mbuesch/moistcontrol/schematics/moistcontrol.pdf

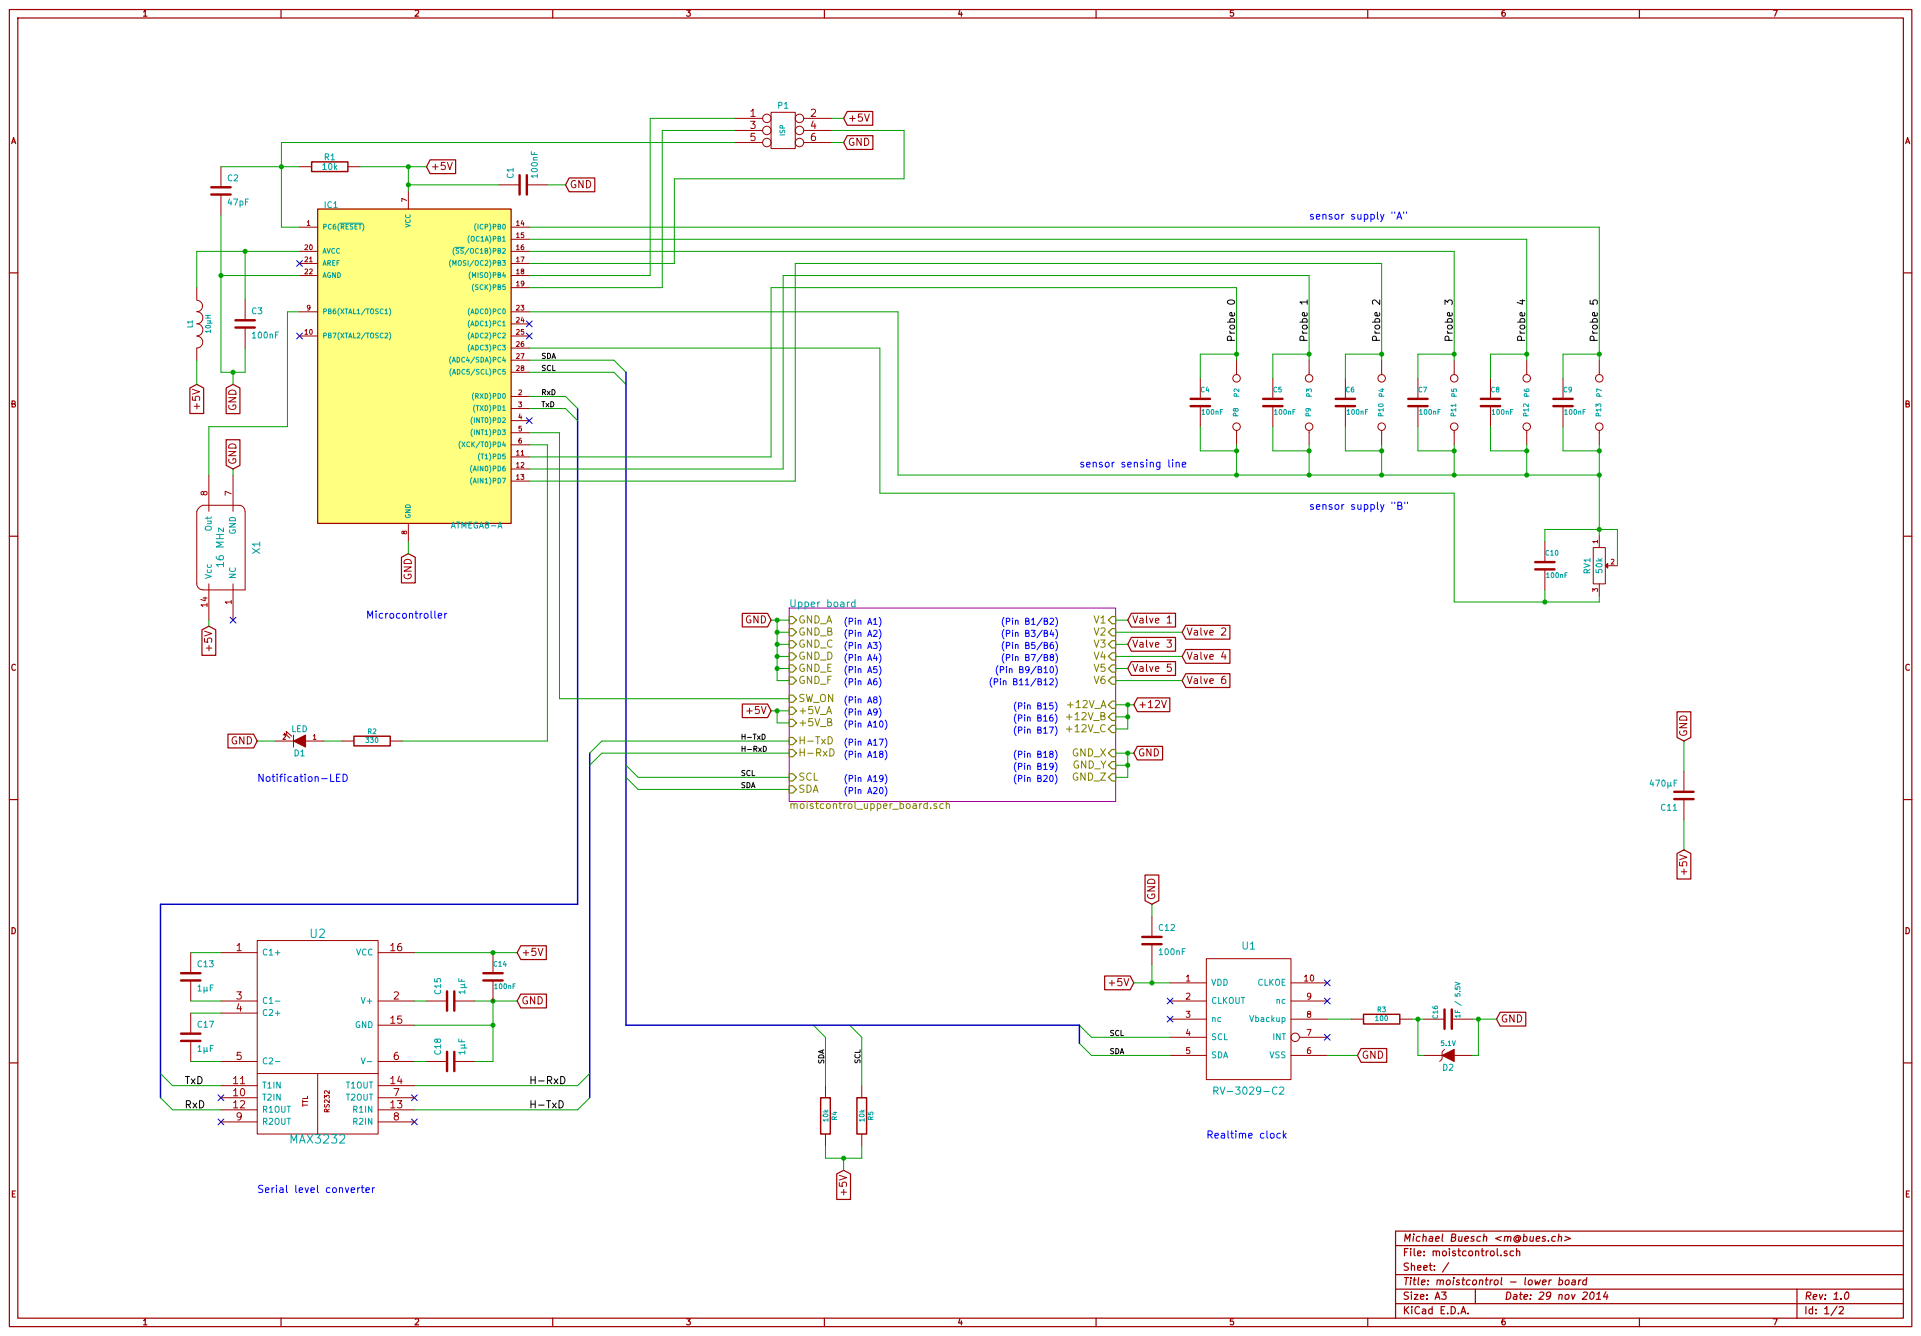
[picture p1: page 1]

sensor sensing line GND

Michael Buesch <m@bues.ch>
Id: 1/2 Title: moistcontrol - lower board File: moistcontrol.sch Sheet: /

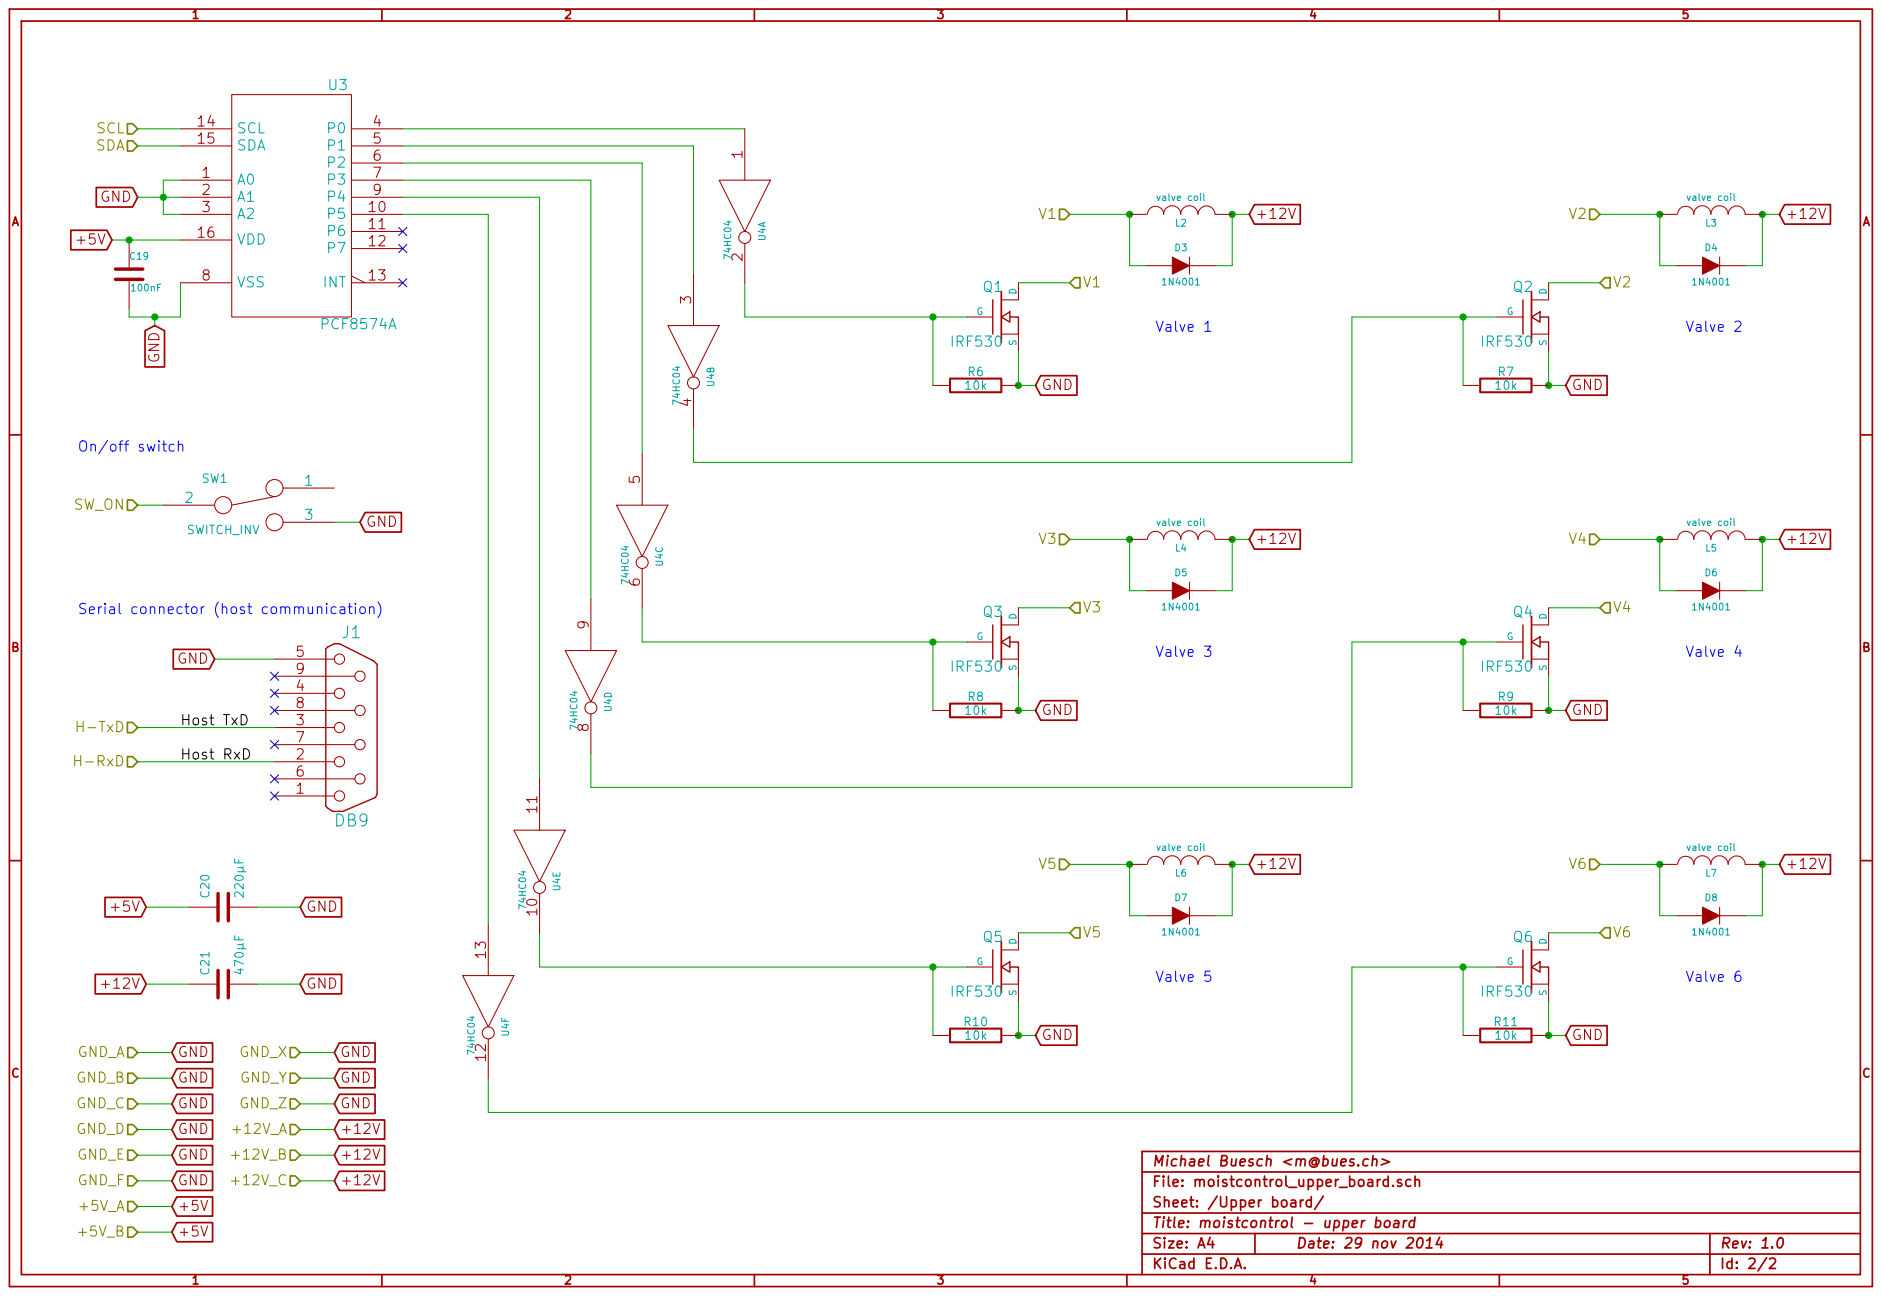
[picture p2: page 2]

Michael Buesch <m@bues.ch>
File: moistcontrol_upper_board.sch
Sheet: /Upper board/
Title: moistcontrol - upper board
