mbuesch/moistcontrol/schematics/moistcontrol.sch

## KiCad design schematics/moistcontrol.sch (2014-12-08)

Schematic: moistcontrol.sch

Parts:
C1, C3, C12: 100nF
C2: 47pF
C4, C5, C6, C7, C8, C9, C10, C14: 100nF
C11: 470µF
C13, C15, C17, C18: 1µF
C16: 1F / 5.5V
D1: LED
D2: 5.1V
IC1: ATMEGA8-A; DIL28
L1: 10µH
P1: ISP
P2, P3, P4, P5, P6, P7, P8, P9, P10, P11, P12, P13: CONN_1
R1: 10k
R2: 330
R3: 100
R4, R5: 10k
RV1: 50k
U1: RV-3029-C2
U2: MAX3232
X1: 16 MHz

Notes on the sheet:
sensor supply "B"
sensor supply "A"
sensor sensing line
(Pin A1)
(Pin A2)
(Pin A3)
(Pin A4)
(Pin A5)
(Pin A6)
(Pin A9)
(Pin A10)
(Pin A19)
(Pin A20)
(Pin A17)
(Pin A18)
Realtime clock
Serial level converter
Microcontroller
(Pin B1/B2)
(Pin B3/B4)
(Pin B5/B6)
(Pin B7/B8)
(Pin B9/B10)
(Pin B11/B12)
(Pin B15)
(Pin B16)
(Pin B17)
(Pin B18)
(Pin B19)
(Pin B20)
Notification-LED
(Pin A8)
