mbuesch/moistcontrol/schematics/moistcontrol_upper_board.sch

## KiCad design schematics/moistcontrol_upper_board.sch (2014-12-08)

Schematic: moistcontrol_upper_board.sch

Parts:
C19: 100nF
C20: 220µF
C21: 470µF
D3, D4, D5, D6, D7, D8: 1N4001
J1: DB9
L2, L3, L4, L5, L6, L7: valve coil
Q1, Q2, Q3, Q4, Q5, Q6: IRF530
R6, R7, R8, R9, R10, R11: 10k
SW1: SWITCH_INV
U3: PCF8574A
U4: 74HC04

Notes on the sheet:
Serial connector (host communication)
Valve 1
Valve 2
Valve 3
Valve 4
Valve 5
Valve 6
On/off switch
