mbuesch/moistcontrol/firmware/notify_led.h

#ifndef NOTIFY_LED_H_
#define NOTIFY_LED_H_

#include "util.h"


void notify_led_set(bool on);
bool notify_led_get(void);

void notify_led_work(void);
void notify_led_init(void);

#endif /* NOTIFY_LED_H_ */
