mbuesch/moistcontrol/(commit log)

2013-12-04 gui: Add missing import
    [potwidgets.py]
2013-12-04 gui-logging: Add missing cgi import
    [logging.py]
2013-12-05 gui: Set poll timer to calculated frame time
2013-12-07 Fix RTC message parsing
    [globalwidgets.py]
2013-12-07 GUI: Add message parsing for error and ADC messages
    [logging.py]
2013-12-15 Fix check of GCC major version number
    [util.h]
2013-12-16 RTC: Fix conversion to and from BCD
    [rv3029.c]
2013-12-16 Documentation update
    [moistcontrol.sch, moistcontrol_upper_board.sch]
2014-01-02 Add ADC value sanity checking
2014-01-17 Add watering watchdog
    [moistcontrol.sch, moistcontrol_upper_board.sch]
2014-12-08 Add on/off hardware switch
    [moistcontrol.sch, moistcontrol_upper_board.sch]
2014-12-08 Fix clearing of remanent watchdog state
    [controller.c]
2015-02-18 Add a button to force start measurement
2015-02-25 controller: Reset measured values on pot reset
    [controller.c]
2015-04-03 re-plot schematics PDF
